wolfgangfriedrich/AnalogShield-01/README.md

# AnalogShield-01
Arduino Schield Pixi Analog I/O 20channel KiCAD design files

Project is hosted at HackADay.io 
https://hackaday.io/project/4397-pixi-analog-shield

Arduino library and sample code are storedin a separate repository 
https://github.com/wolfgangfriedrich/Pixi_demo
