wolfgangfriedrich/AnalogShield-01/AnalogShield-01_sch.pdf

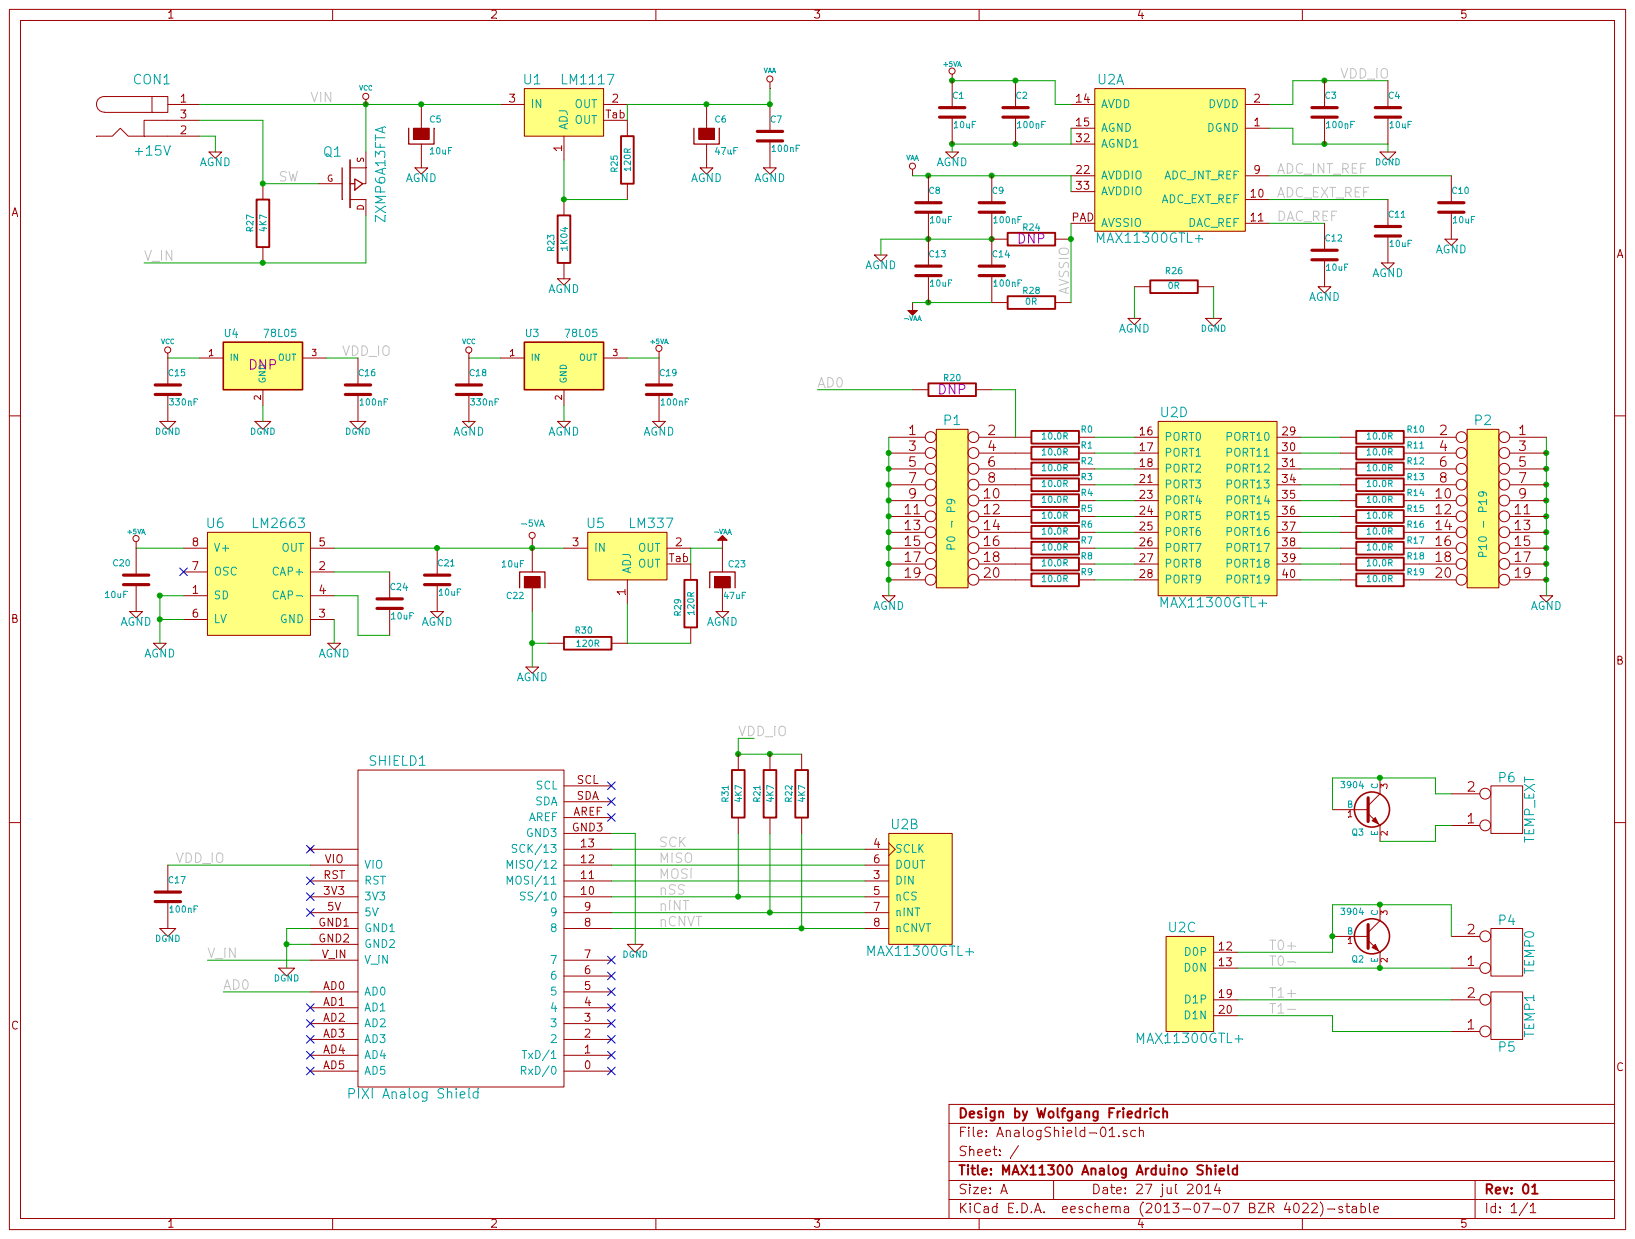
[picture p1: page 1]
