wolfgangfriedrich/AnalogShield-01/AnalogShield-01.kicad_pcb

## KiCad design AnalogShield-01.kicad_pcb (2015-12-27)

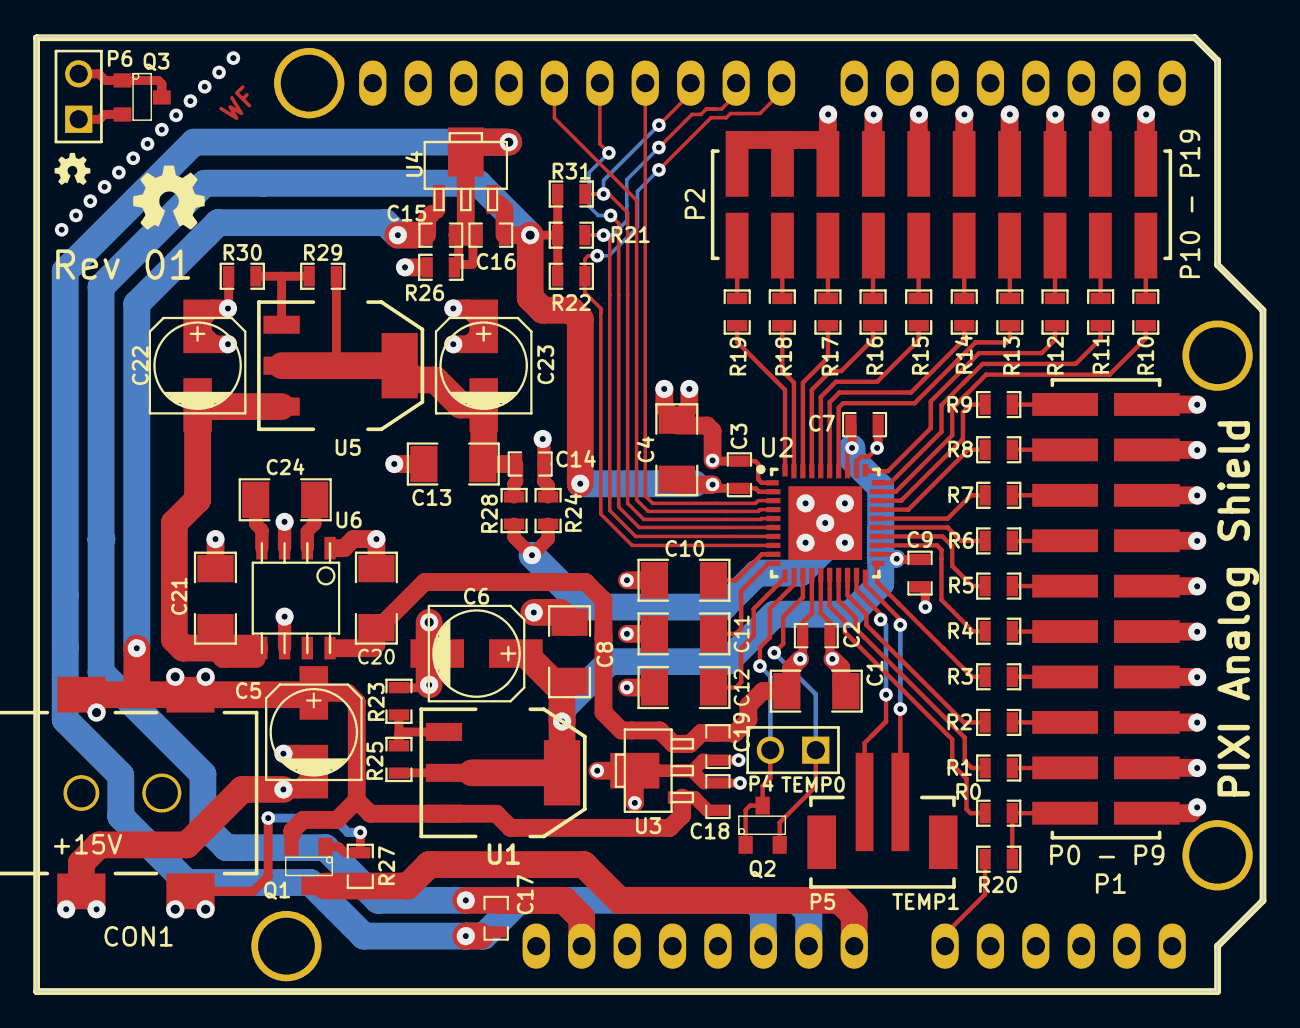
[picture p2: board AnalogShield-01.kicad_pcb from above]

Board: 2 copper layers, 68.6 x 53.4 mm, 74 parts (0 on the bottom side), 71 nets.

Parts:
C1, C4, C8, C10, C11, C12, C13, C20, C21, C24: 10uF; SM1206
C2, C3, C7, C9, C14, C16, C17, C19: 100nF; SM0603_Capa
C5, C22: 10uF; c_elec_5x5.8
C6, C23: 47uF; c_elec_5x5.8
C15, C18: 330nF; SM0603_Capa
CON1: +15V; ADAM_ADC-028
G1: OSHW-logo_silkscreen-front_4mm
G2: OSHW-logo_silkscreen-front_2mm
P1: P0 - P9; Molex_015912200
P2: P10 - P19; Molex_015912200
P4: TEMP0; PIN_ARRAY_2X1
P5: TEMP1; JST_B2B-PH-SM4-TB
P6: TEMP_EXT; PIN_ARRAY_2X1
Q1: ZXMP6A13FTA; SOT23
Q2, Q3: 3904; SOT23
R0, R1, R2, R3, R4, R5, R6, R7, R8, R9, R10, R11, R12, R13, R14, R15, R16, R17, R18, R19: 10.0R; SM0603_Resistor
R20, R24, R26, R28: 0R; SM0603_Resistor
R21, R22, R27, R31: 4K7; SM0603_Resistor
R23: 1K04; SM0603_Resistor
R25, R29, R30: 120R; SM0603_Resistor
SHIELD1: PIXI Analog Shield; ARDUINO_SHIELD_rev03
U1: LM1117; SOT223
U2: MAX11300GTL+; QFN50P-60X60-41N
U3, U4: 78L05; sot89
U5: LM337; SOT223
U6: LM2663; so-8

Connections:
+5VA: C1.1, C2.1, C19.1, C20.1, U2.14, U3.3, U6.8
-5VA: C21.1, C22.2, U5.3, U6.5
-VAA: C13.2, C14.2, C23.2, R28.1, R29.1, U5.2, U5.Tab
/AD0: R20.1, SHIELD1.AD0
/ADC_EXT_REF: C11.1, U2.10
/ADC_INT_REF: C10.1, U2.9
/AVSSIO: R24.2, R28.2, U2.PAD
/DAC_REF: C12.1, U2.11
/MISO: SHIELD1.12, U2.6
/MOSI: SHIELD1.11, U2.3
/SCK: SHIELD1.13, U2.4
/SW: CON1.3, Q1.G, R27.1
/T0+: P4.2, Q2.1, Q2.3, U2.12
/T0-: P4.1, Q2.2, U2.13
/T1+: P5.2, U2.19
/T1-: P5.1, U2.20
/VDD_IO: C3.1, C4.1, C16.1, C17.1, R21.1, R22.1, R31.1, SHIELD1.VIO, U2.2, U4.3
/V_IN: Q1.D, R27.2, SHIELD1.V_IN
/nCNVT: R22.2, SHIELD1.8, U2.8
/nINT: R21.2, SHIELD1.9, U2.7
/nSS: R31.2, SHIELD1.10, U2.5
AGND: C1.2, C2.2, C5.2, C6.2, C7.2, C8.2, C9.2, C10.2, C11.2, C12.2, C13.1, C14.1, C18.2, C19.2, C20.2, C21.2, C22.1, C23.1, CON1.2, P1.1, P1.3, P1.5, P1.7, P1.9, P1.11, P1.13, P1.15, P1.17, P1.19, P2.1, P2.3, P2.5, P2.7, P2.9, P2.11, P2.13, P2.15, P2.17, P2.19, R23.2, R24.1, R26.1, R30.2, U2.15, U2.32, U3.2, U6.1, U6.3, U6.6
DGND: C3.2, C4.2, C15.2, C16.2, C17.2, R26.2, SHIELD1.GND1, SHIELD1.GND2, SHIELD1.GND3, U2.1, U4.2
unnamed: C24.1, U6.2
unnamed: C24.2, U6.4
unnamed: P1.2, R0.1, R20.2
unnamed: P1.4, R1.1
unnamed: P1.6, R2.1
unnamed: R29.2, R30.1, U5.1
unnamed: P2.4, R11.2
unnamed: P2.8, R13.2
unnamed: P2.12, R15.2
unnamed: R7.2, U2.26
unnamed: P2.10, R14.2
unnamed: P2.14, R16.2
unnamed: P2.18, R18.2
unnamed: P2.2, R10.2
unnamed: P1.16, R7.1
unnamed: P1.10, R4.1
unnamed: P1.12, R5.1
unnamed: P1.14, R6.1
unnamed: P1.18, R8.1
unnamed: P2.16, R17.2
unnamed: P2.20, R19.2
unnamed: R1.2, U2.17
unnamed: P1.8, R3.1
unnamed: R8.2, U2.27
unnamed: R2.2, U2.18
unnamed: P1.20, R9.1
unnamed: P2.6, R12.2
unnamed: P6.2, Q3.1, Q3.3
unnamed: P6.1, Q3.2
unnamed: R11.1, U2.30
unnamed: R19.1, U2.40
unnamed: R3.2, U2.21
unnamed: R12.1, U2.31
unnamed: R4.2, U2.23
unnamed: R5.2, U2.24
unnamed: R13.1, U2.34
unnamed: R6.2, U2.25
unnamed: R14.1, U2.35
unnamed: R0.2, U2.16
unnamed: R10.1, U2.29
unnamed: R15.1, U2.36
unnamed: R16.1, U2.37
unnamed: R9.2, U2.28
unnamed: R17.1, U2.38
unnamed: R18.1, U2.39
unnamed: R23.1, R25.2, U1.1
VAA: C6.1, C7.1, C8.1, C9.1, R25.1, U1.2, U1.Tab, U2.22, U2.33
VCC: C5.1, C15.1, C18.1, CON1.1, Q1.S, U1.3, U3.1, U4.1
