wolfgangfriedrich/AnalogShield-01/(threads)

Thread 1 (2017-02-23):

The kicad schematic does not have the schematic parts, notably the MAX11300, please upload the required parts as a .lib

MarkAYLOTT, 2017-02-23:

MarkAYLOTT, 2017-02-23:
Solved issue, converted from Eagle .lbr

Closed 2017-02-23.
